hsg0/TOF-motion-detection-camera-system/(commit log)

2026-10-25 Update README.md to clarify system connections and wiring details, including corrections to component labels and wiring instructions. Added a flowchart for better visualization of the connections bet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
2026-10-29 Add detailed section on model deployment and hardware interactions in WIRING.md, including specifications for Hailo board, CPU usage for language models, and firmware compatibility for model loading.
2026-10-29 Enhance WIRING.md with additional details on model deployment, including updated specifications for Hailo board and improved CPU usage metrics for language models.
